egc365/Voron-Cascade/STLs/Electronics/Frame Enclosure/Frame Enclosure Latch Corner/[pp-s]_panel_latch_corner_mount_B.stl

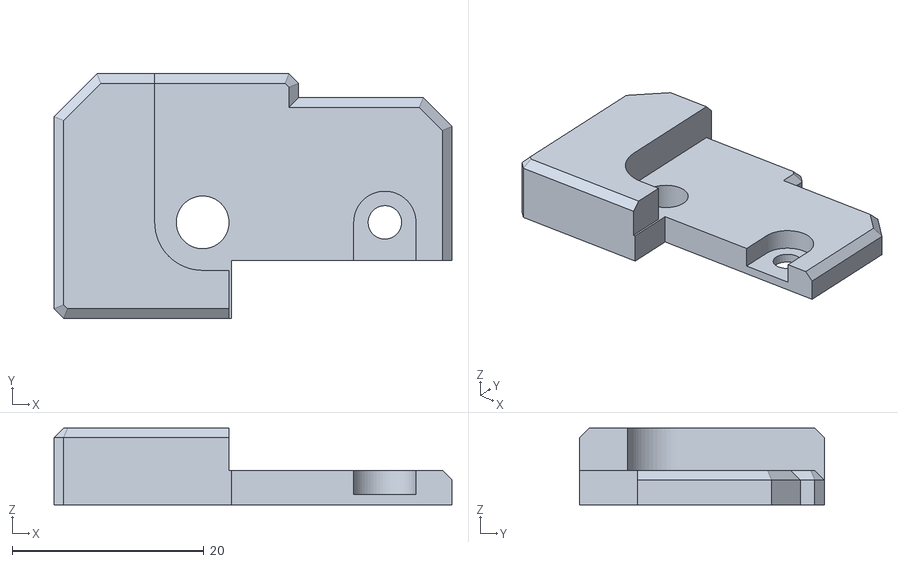
[picture p1: CAD file, 2026-10-02]
STLs/Electronics/Frame Enclosure/Frame Enclosure Latch Corner/[pp-s]_panel_latch_corner_mount_B.stl
41.5 x 25.5 x 8.00
