egc365/Voron-Cascade/STLs/Tools_and_guides/[pp-p]_drill_jig_frame_base_gantry.stl

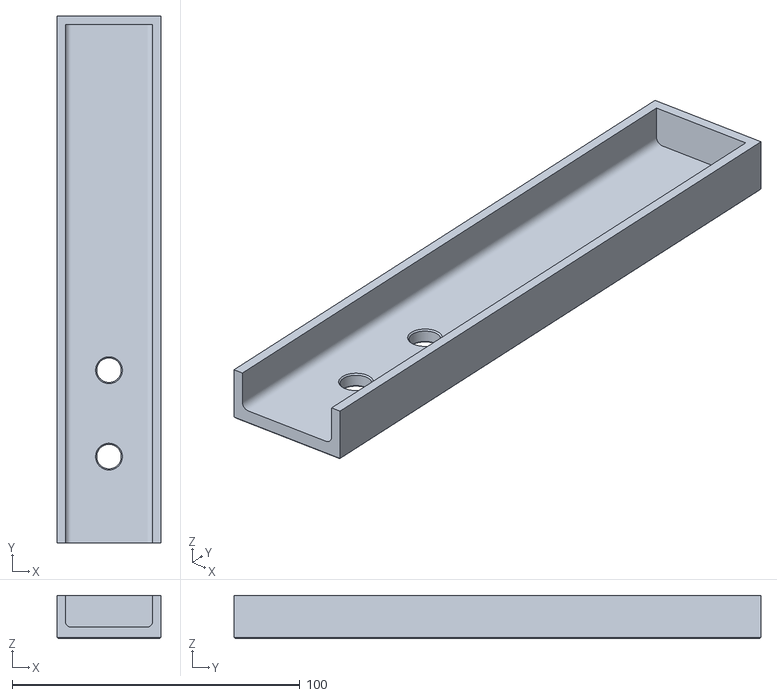
[picture p2: CAD file, 2026-05-18]
STLs/Tools_and_guides/[pp-p]_drill_jig_frame_base_gantry.stl
36.0 x 183.0 x 15.0
