egc365/Voron-Cascade/STLs/Working_enclosure/[pp-s]_3060_end_cap_enclosure_panel_clip_x4.stl

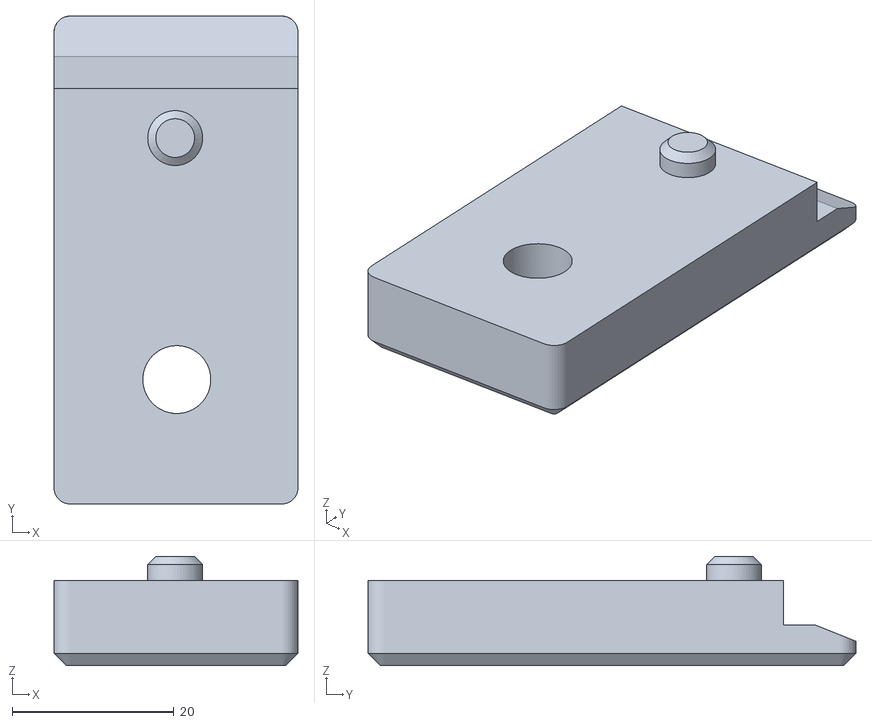
[picture p3: CAD file, 2026-05-18]
STLs/Working_enclosure/[pp-s]_3060_end_cap_enclosure_panel_clip_x4.stl
30.2 x 60.4 x 13.5
