egc365/Voron-Cascade/STLs/Working_enclosure/Gantry Trim/[pp-s]_3060_end_cap_logo.stl

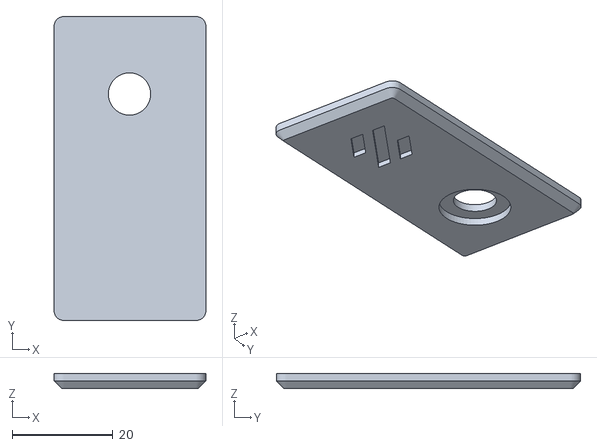
[picture p4: CAD file, 2026-05-18]
STLs/Working_enclosure/Gantry Trim/[pp-s]_3060_end_cap_logo.stl
30.2 x 60.4 x 3.00
