egc365/Voron-Cascade/STLs/Tools_and_guides/[pp-p]_drill_jig_frame_base_rails.stl

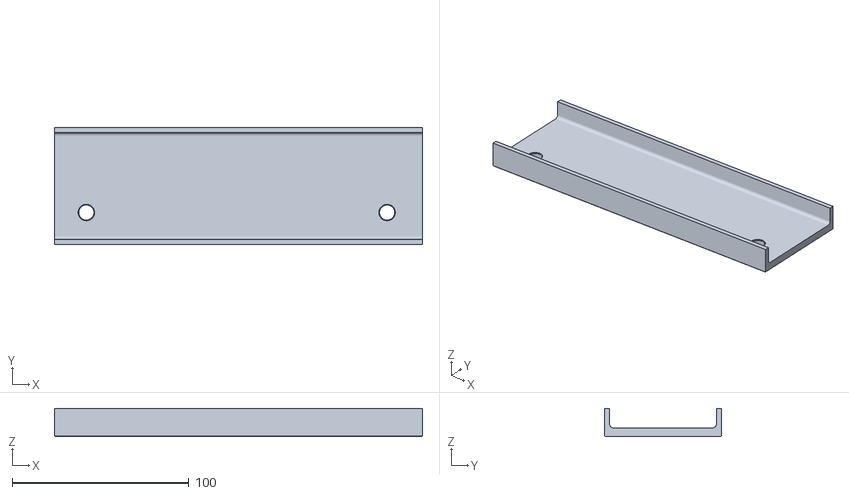
[picture p5: CAD file, 2026-05-18]
STLs/Tools_and_guides/[pp-p]_drill_jig_frame_base_rails.stl
208.0 x 66.0 x 16.0
