egc365/Voron-Cascade/STLs/Working_enclosure/[pp-p]_working_enclosure_rear_mount_left.stl

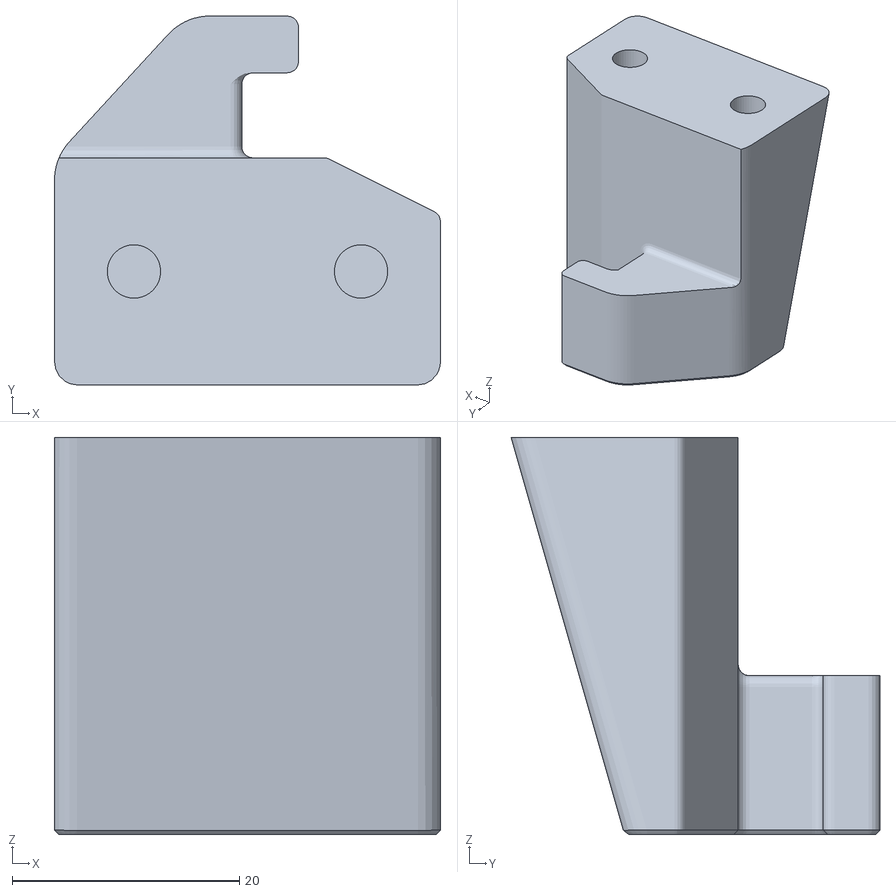
[picture p6: CAD file, 2026-05-18]
STLs/Working_enclosure/[pp-p]_working_enclosure_rear_mount_left.stl
34.0 x 32.5 x 35.0
