egc365/Voron-Cascade/STLs/Working_enclosure/Gantry Trim/[pp-p]_gantry_front_brace_cover_x2.stl

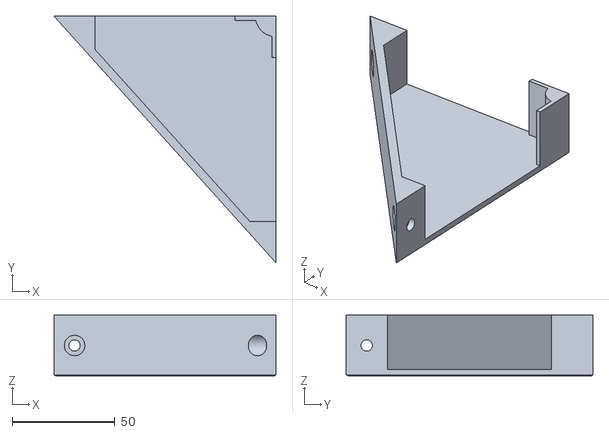
[picture p7: CAD file, 2026-05-18]
STLs/Working_enclosure/Gantry Trim/[pp-p]_gantry_front_brace_cover_x2.stl
108.0 x 120.0 x 29.5
