egc365/Voron-Cascade/STLs/Tools_and_guides/[pp-p]_alignment_tool_y_axis.stl

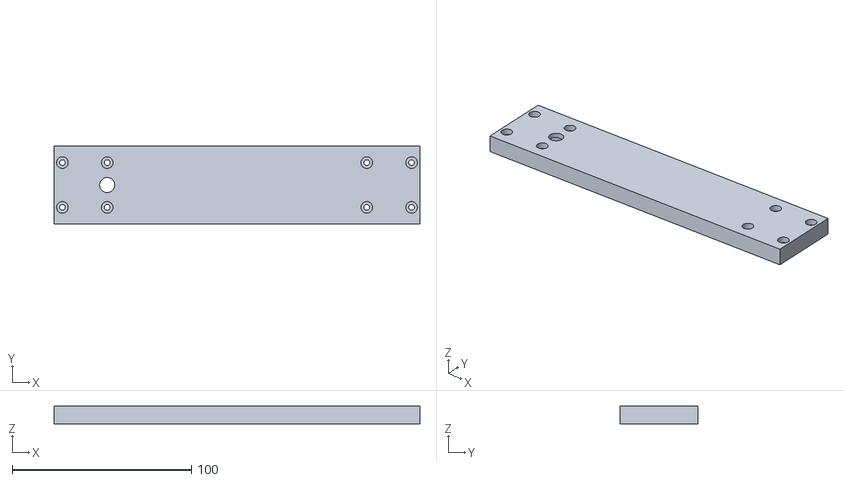
[picture p8: CAD file, 2026-05-18]
STLs/Tools_and_guides/[pp-p]_alignment_tool_y_axis.stl
204.4 x 43.4 x 10.0
