egc365/Voron-Cascade/STLs/Tools_and_guides/[pp-p]_drill_template_60mm_fan_with_keystones.stl

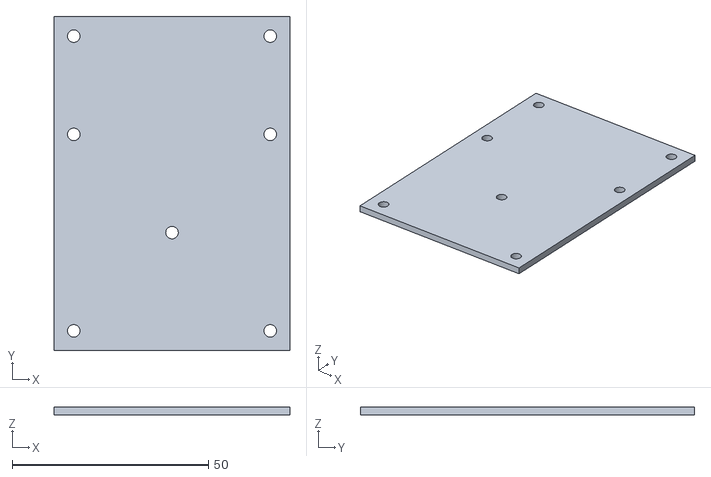
[picture p10: CAD file, 2026-05-18]
STLs/Tools_and_guides/[pp-p]_drill_template_60mm_fan_with_keystones.stl
60.0 x 85.0 x 2.00
