egc365/Voron-Cascade/STLs/Working_enclosure/[pp-p]_enclosure_handle_x3.stl

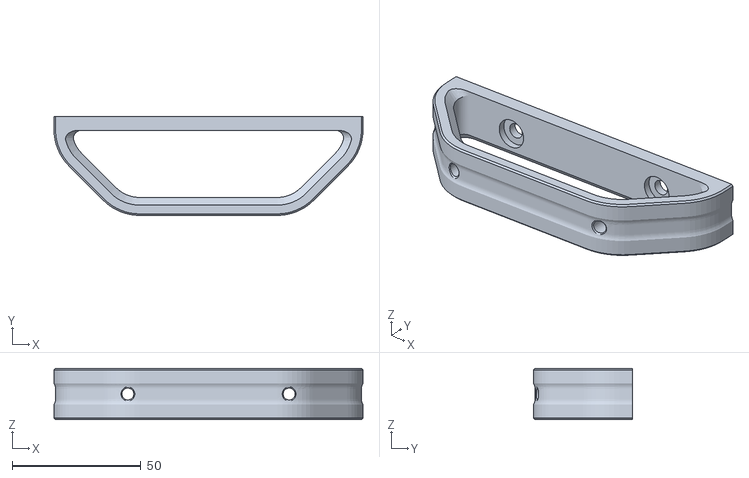
[picture p11: CAD file, 2026-05-18]
STLs/Working_enclosure/[pp-p]_enclosure_handle_x3.stl
120.0 x 38.4 x 20.0
