egc365/Voron-Cascade/STLs/Working_enclosure/Gantry Trim/[pp-p]_cable_protection_fitting.stl

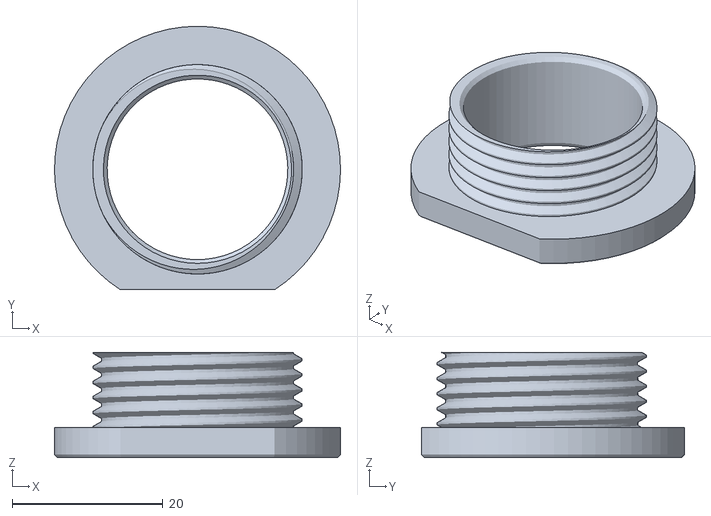
[picture p12: CAD file, 2026-05-18]
STLs/Working_enclosure/Gantry Trim/[pp-p]_cable_protection_fitting.stl
38.0 x 35.0 x 14.0
