egc365/Voron-Cascade/STLs/Working_enclosure/[pp-c]_daylight_cover.stl

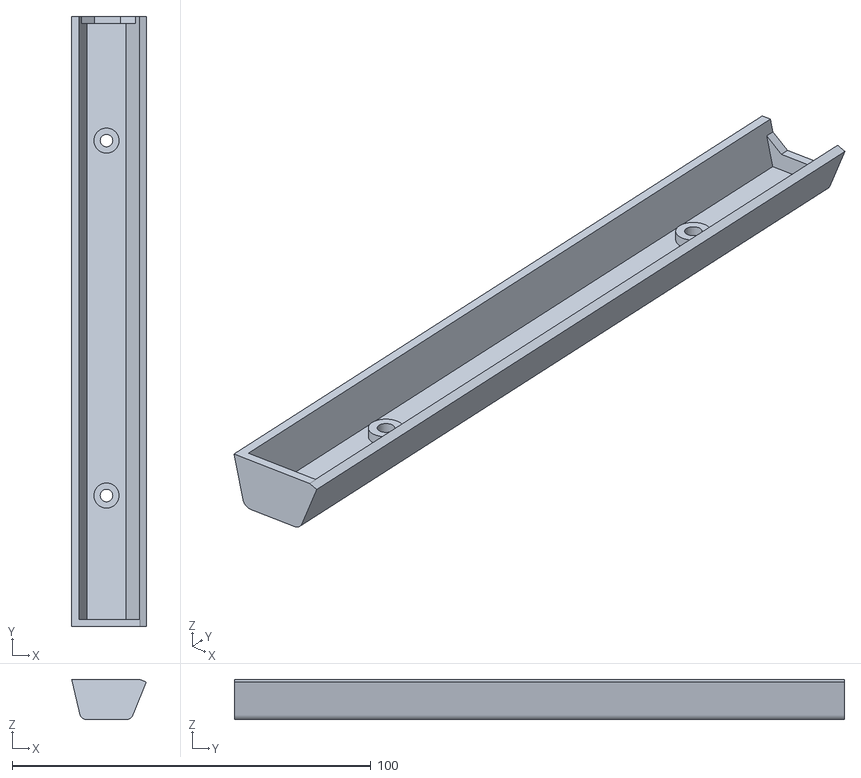
[picture p14: CAD file, 2026-05-18]
STLs/Working_enclosure/[pp-c]_daylight_cover.stl
20.8 x 170.0 x 11.2
