egc365/Voron-Cascade/STLs/Working_enclosure/[pp-s]_3030_enclosure_panel_clip_x6.stl

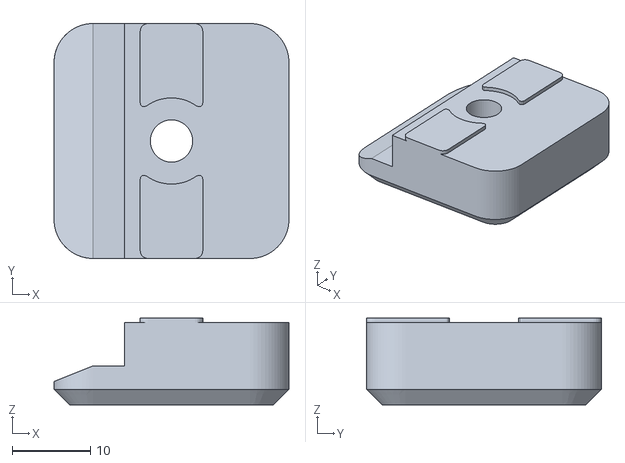
[picture p15: CAD file, 2026-05-18]
STLs/Working_enclosure/[pp-s]_3030_enclosure_panel_clip_x6.stl
30.0 x 30.0 x 11.1
