egc365/Voron-Cascade/STLs/Working_enclosure/Gantry Trim/[pp-p]_x_drive_debris_cover_right.stl

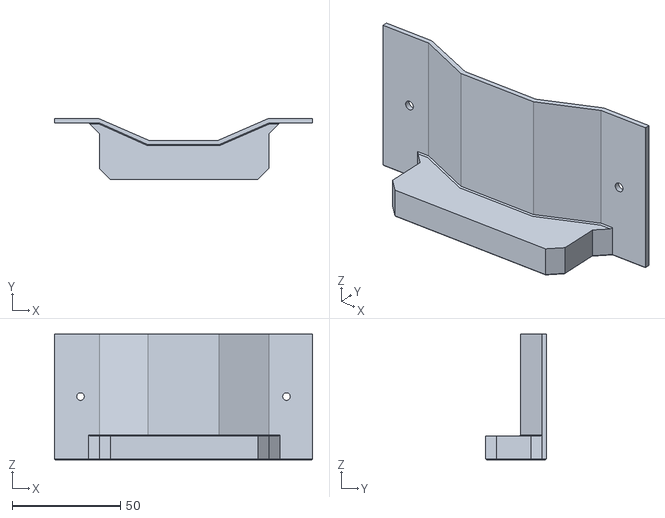
[picture p16: CAD file, 2026-05-18]
STLs/Working_enclosure/Gantry Trim/[pp-p]_x_drive_debris_cover_right.stl
119.0 x 28.0 x 58.0
