egc365/Voron-Cascade/STLs/Tools_and_guides/[pp-p]_drill_template_display_mount.stl

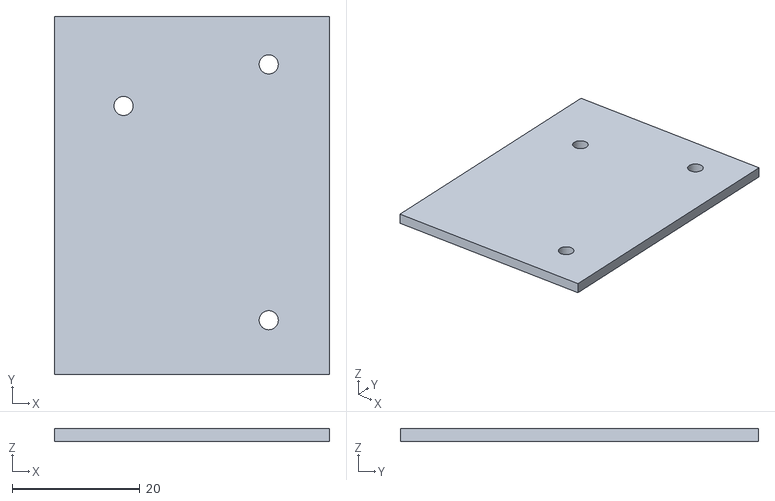
[picture p17: CAD file, 2026-05-18]
STLs/Tools_and_guides/[pp-p]_drill_template_display_mount.stl
43.0 x 56.0 x 2.00
