egc365/Voron-Cascade/STLs/Working_enclosure/[pp-p]_working_enclosure_frame_mount_front.stl

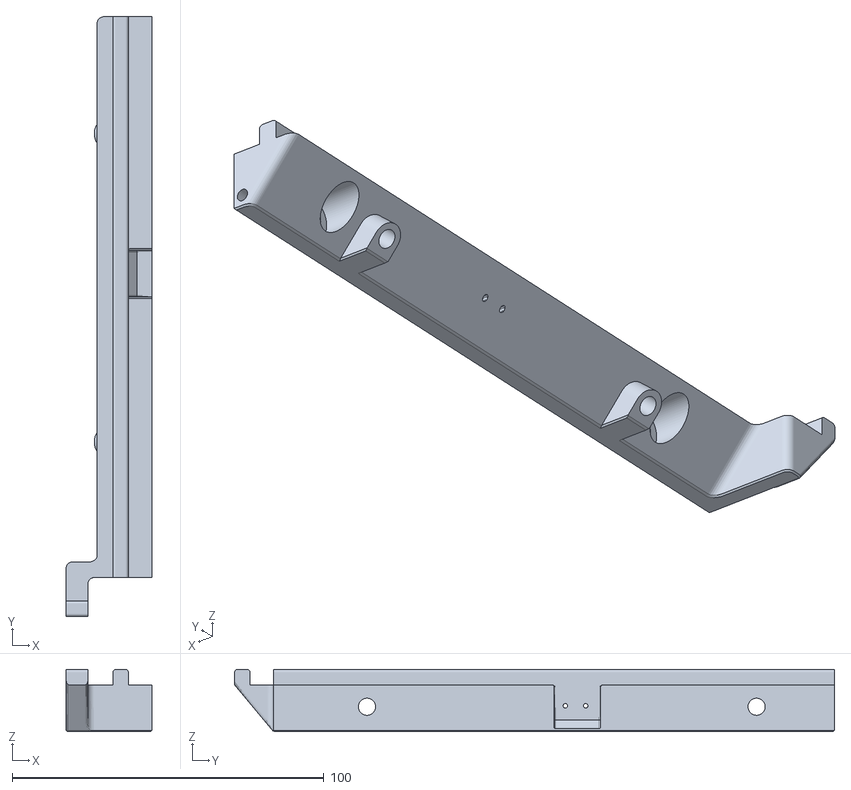
[picture p18: CAD file, 2026-05-18]
STLs/Working_enclosure/[pp-p]_working_enclosure_frame_mount_front.stl
27.5 x 192.5 x 20.0
