egc365/Voron-Cascade/STLs/Tools_and_guides/[pp-p]_drill_template_power_inlet.stl

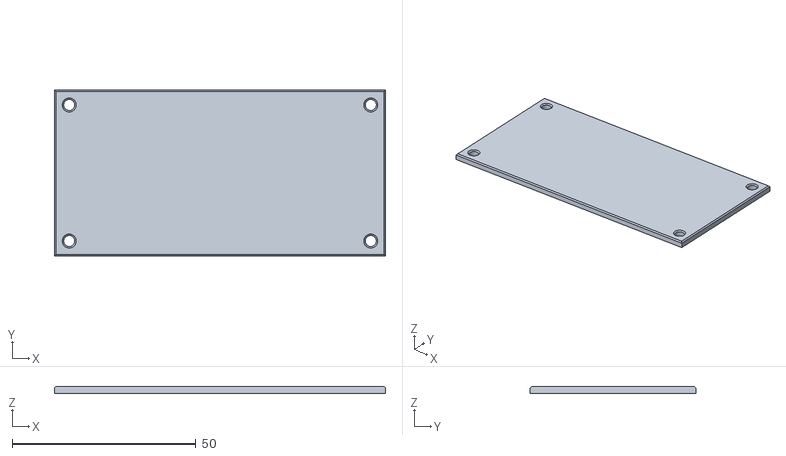
[picture p19: CAD file, 2026-05-18]
STLs/Tools_and_guides/[pp-p]_drill_template_power_inlet.stl
90.0 x 45.0 x 2.00
