egc365/Voron-Cascade/STLs/Tools_and_guides/[pp-p]_drill_jig_gantry_frame_right.stl

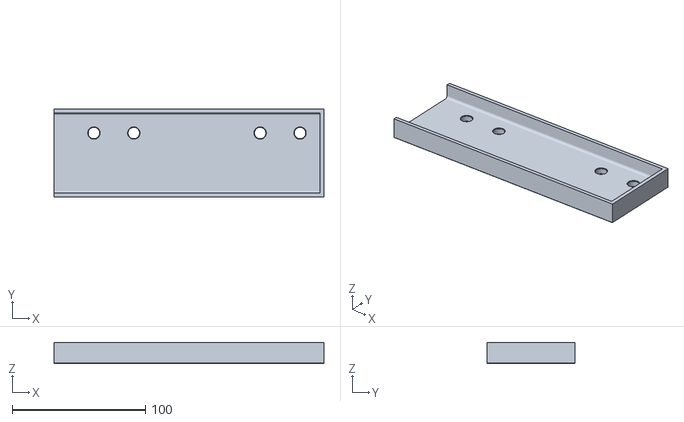
[picture p20: CAD file, 2026-05-18]
STLs/Tools_and_guides/[pp-p]_drill_jig_gantry_frame_right.stl
203.0 x 66.0 x 16.0
