egc365/Voron-Cascade/STLs/Tools_and_guides/[pp-p]_drill_template_60mm_fan.stl

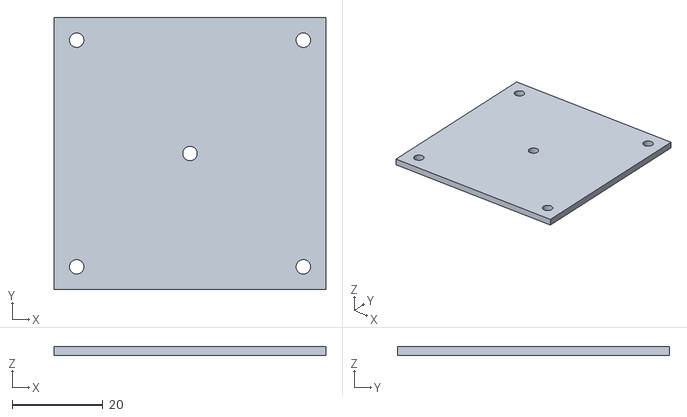
[picture p21: CAD file, 2026-05-18]
STLs/Tools_and_guides/[pp-p]_drill_template_60mm_fan.stl
60.0 x 60.0 x 2.00
