egc365/Voron-Cascade/STLs/Tools_and_guides/[pp-p]_alignment_guide_2020_mgn15_x2.stl

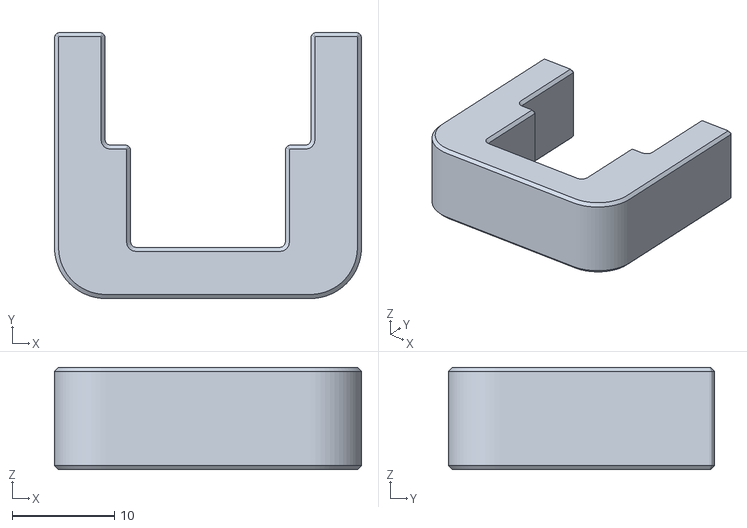
[picture p22: CAD file, 2026-05-18]
STLs/Tools_and_guides/[pp-p]_alignment_guide_2020_mgn15_x2.stl
30.0 x 26.0 x 10.0
