egc365/Voron-Cascade/STLs/Tools_and_guides/[pp-p]_alignment_tool_x_axis.stl

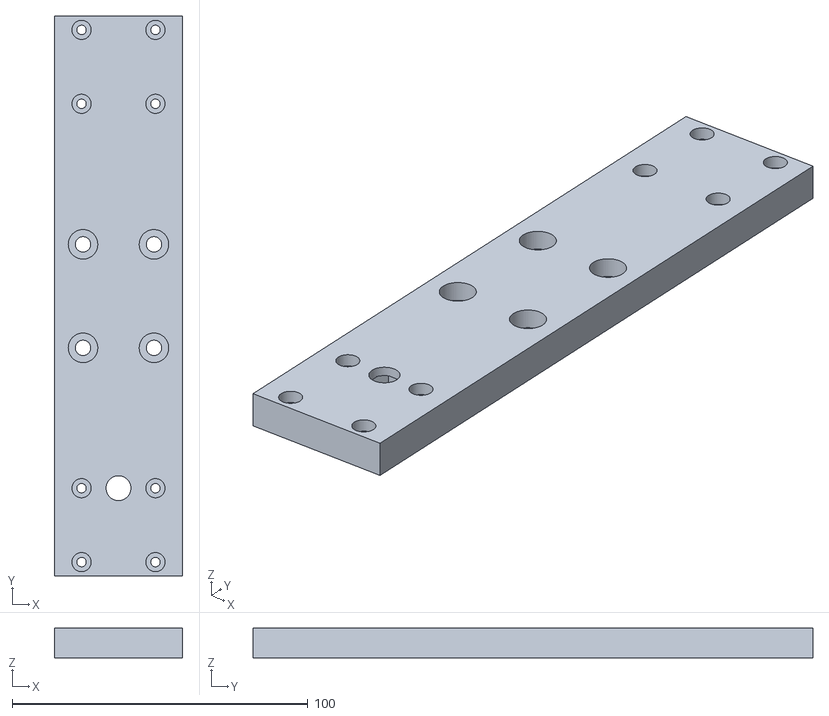
[picture p23: CAD file, 2026-05-18]
STLs/Tools_and_guides/[pp-p]_alignment_tool_x_axis.stl
43.4 x 189.4 x 10.00
