egc365/Voron-Cascade/STLs/Tools_and_guides/[pp-p]_tramming_bar.stl

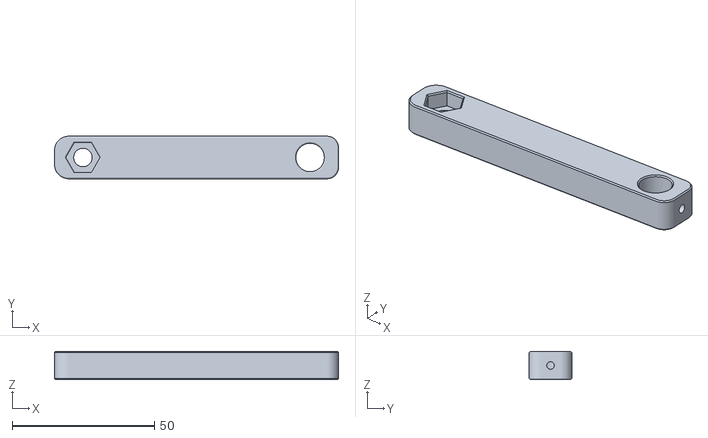
[picture p24: CAD file, 2026-05-18]
STLs/Tools_and_guides/[pp-p]_tramming_bar.stl
100.0 x 15.0 x 10.0
