egc365/Voron-Cascade/STLs/Tools_and_guides/[pp-p]_alignment_guide_3060_mgn15_x2.stl

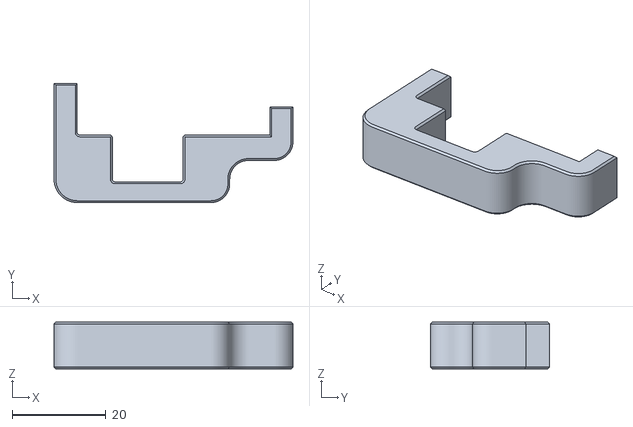
[picture p25: CAD file, 2026-05-18]
STLs/Tools_and_guides/[pp-p]_alignment_guide_3060_mgn15_x2.stl
51.0 x 25.5 x 10.0
