egc365/Voron-Cascade/STLs/Tools_and_guides/[pp-p]_setup_tool_z.stl

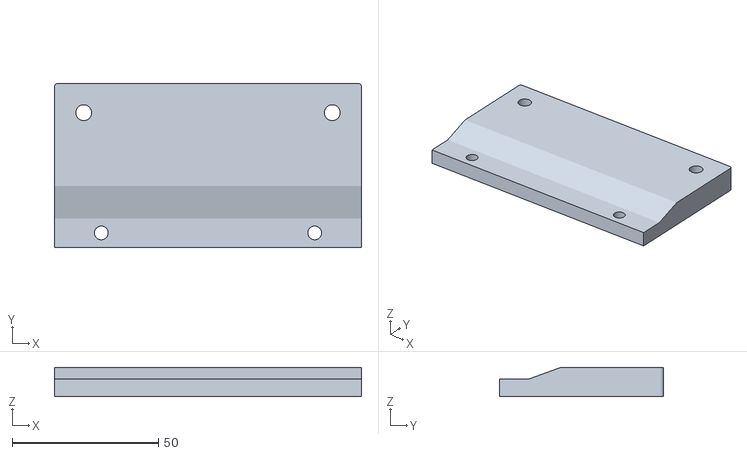
[picture p26: CAD file, 2026-05-18]
STLs/Tools_and_guides/[pp-p]_setup_tool_z.stl
105.0 x 56.1 x 10.0
