egc365/Voron-Cascade/STLs/Tools_and_guides/[pp-p]_drill_jig_frame_base_corners.stl

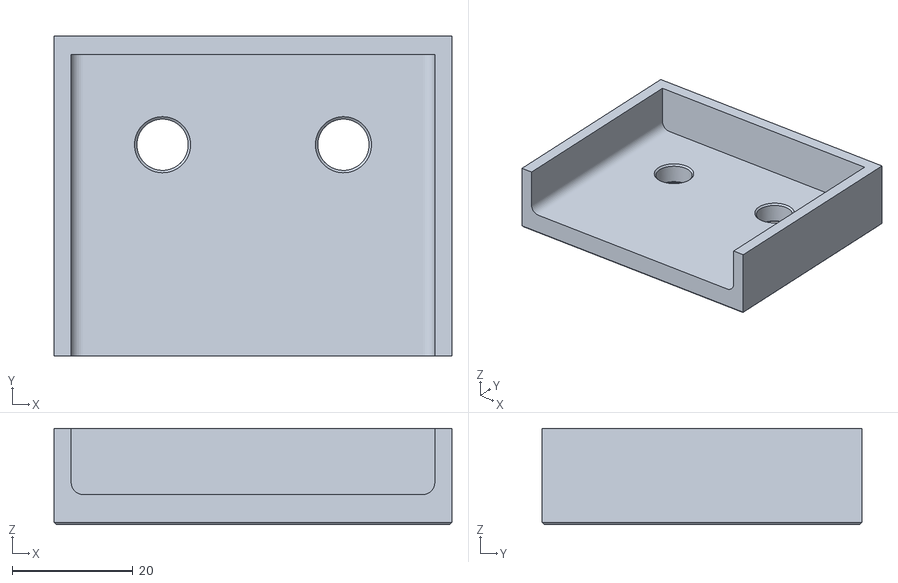
[picture p27: CAD file, 2026-05-18]
STLs/Tools_and_guides/[pp-p]_drill_jig_frame_base_corners.stl
66.0 x 53.0 x 16.0
