egc365/Voron-Cascade/STLs/Tools_and_guides/[pp-p]_alignment_tool_y_drive.stl

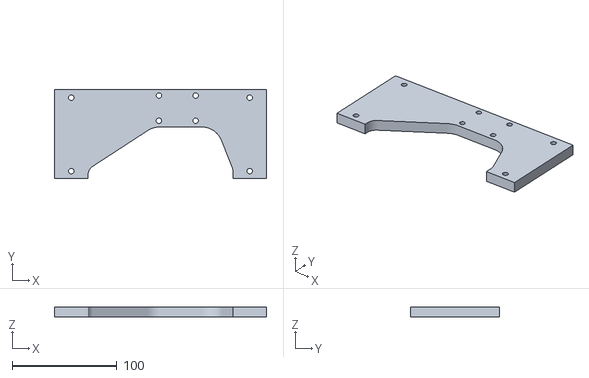
[picture p28: CAD file, 2026-05-18]
STLs/Tools_and_guides/[pp-p]_alignment_tool_y_drive.stl
202.0 x 85.3 x 10.0
