egc365/Voron-Cascade/(list of files, cad)

Other CAD files:
STLs/Working_enclosure/[pp-p]_working_enclosure_rear_mount_right.stl
STLs/Tools_and_guides/[pp-p]_drill_jig_gantry_frame_left.stl
STLs/Tools_and_guides/[pp-p]_1204_screw_clamp_A.stl
STLs/Tools_and_guides/[pp-p]_1204_screw_clamp_B.stl
STLs/Tools_and_guides/[pp-p]_ballscrew_1204_maint_tool_v2.stl
STLs/Tools_and_guides/[pp-p]_x_spacer_washer_guide.stl
STLs/Working_enclosure/Gantry Trim/[pp-p]_cable_protection_nut.stl
