egc365/Voron-Cascade/build/vision/renders/side.png

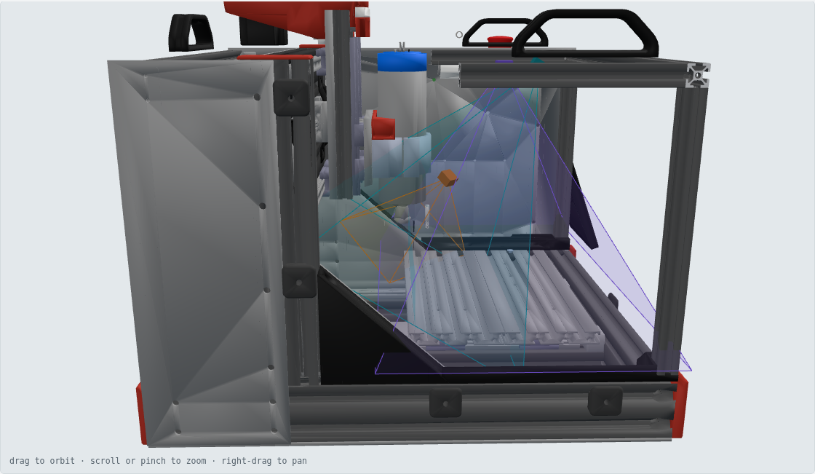
build/vision/renders/side.png
