egc365/Voron-Cascade/(commit log)

2026-05-18 Updated Y drive alignment jig
    [[pp-c]_daylight_cover.stl, [pp-p]_1204_screw_clamp_A.stl, [pp-p]_1204_screw_clamp_B.stl, [pp-p]_alignment_guide_2020_mgn15_x2.stl, [pp-p]_alignment_guide_3030_mgn15_x2.stl, [pp-p]_alignment_guide_3060_mgn15_x2.stl, [pp-p]_alignment_tool_x_axis.stl, [pp-p]_alignment_tool_y_axis.stl]
2026-10-02 Add build kickoff kit and vision rig study
    - build/config.json: build choices (spindle, controller, table, Z plate,
    printed variants, printer bed)
    - build/tools/print_list.py: measures every STL, applies BOM quantities and
    config choices, estimates filament -> build/print_list.csv
    - build/tools/purchase_list.py: BOM -> config-aware purchase list
    - Add the missing [pp-s]_panel_latch_corner_mount_B STL (mirror of A,
    verified against the assembly CAD to within 0.04 mm)
    - build/vision: camera placement for an in-enclosure vision rig and digital
    twin, ray-traced against the assembly; 3D page and renders
    - build/tools: STEP -> GLB, slimming, web export, render scripts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
    [[pp-s]_panel_latch_corner_mount_B.stl, print_list.csv, purchase_list.csv]
